jonsole/AmigaRGBtoHDMI/Amiga500CPLD/README.md

# Amiga 500 CPLD RGBtoHDMI

Amiga 500 CPLD RGBtoHDMI

This adaptor uses a CPLD to pass the RGB and sync signals from the Amiga 500 Denise socket to the Rasperry Pi Zero. It derives the pixel clock in a very different way to the c0pperdragon design and therefore does not require a jumper for Denise / Super Denise and has no "sparkling" pixel issues. It also has the advantage of being firmware upgradable if there are any issues found in the logic.

**ATTENTION PI Zero 2W users**: You can now use a Pi Zero 2W with the CPLD RGBtoHDMI using the December 24th 2021 release.

## BOM

| Symbol | Component |
| --- | --- |
| C1 - C3 | 0.1uF 0603 |
| J1 | 2x20pin 16.5mm tall socket 2.54mm |
| JP1 | 2pin right angle header 2.54mm |
| J2 | 1pin right angle header 2.54mm |
| R1 | 1K 0603 |
| R2 | 4.7K 0603 |
| U1 | 48pin DIP socket 2.54mm |
| U2 | 2x24pin SILs machined pins 2.54mm |
| U3 | XC9572XL 44pin QFP |

### Notes

- It is important that R1 is 1K due to the low value of the internal pull resistor in GPIO0 of the Pi, the other pull resistors are more flexible (R1 is optional as the Pi will pull this internally). If the value is too high then the software won't detect this is an Amiga board and won't show the correct firmware in the recovery menu.
- You'll need some kind of push button to connect to JP1
- J2 is optional, it is only needed for revision 3 motherboards to clip onto pin 9 of U41 on the Amiga (photo coming soon)
- The Pi mounting holes are M2.5, 11mm posts or 10mm with 1mm washers are recommended

## Pi Software Installation

The software on the Pi should be at least the latest 20210529 release from the [main tree](https://github.com/hoglet67/RGBtoHDMI/releases) or the latest [IanSB beta release](https://github.com/IanSB/RGBtoHDMI/releases) extracted onto a micro SD card in FAT32 format.

You need to copy some canned profile files into place for the board:

* `Amiga_CPLD_Readme/Amiga_CPLD_Setup/profile_6-12_BIT_RGB.txt` to the root of the SD card
* `Amiga_CPLD_Readme/Amiga_CPLD_Setup/Profiles/Default.txt` to the `Profiles` directory

This resolves some issues with mode switching, particularly on NTSC machines. The profile copied will automatically set `single_button_mode`.

## Flashing the CPLD

The CPLD will need flashing with the `6-12_BIT_RGB_CPLD` firmware. The other firmware options are not compatible with the profiles.

If you have followed the software steps above you will get a recovery menu, select `6-12_BIT_RGB_CPLD`, confirm and the Pi will flash the CPLD and reboot. You can then jump to the Initial Setup section below.

## Initial Setup

You may also a shimmer or wavy effect. This is because the phase is set incorrectly and needs calibration, this is a one-off easy thing to do. If you have a static image such as the Kickstart 1.3 boot screen or Workbench with no mouse movement you can use the "Auto Calibrate Video Settings" option (it will require you to select twice to activate). Alternatively you can go into the "Sampling" menu and change the "Sampling Phase" until the image looks correct. Typically 0, 3 or 5 will work fine, but it could be different in each machine.

Once calibrated choose "Save Configuration" and this will be remembered for subsequent boots.

## Buying PCBs

I've made the [PCBs available on PCBWay](https://www.pcbway.com/project/shareproject/Amiga_500_CPLD_RGBtoHDMI_v2_fb52eff9.html).

You can also purchase PCBs from me [via Tindie](https://www.tindie.com/products/linuxjedi/amiga-500-rgb-to-hdmi-pcb/).
