jonsole/AmigaRGBtoHDMI/Amiga500CPLD/A500.kicad_pcb

## KiCad design Amiga500CPLD/A500.kicad_pcb (2026-03-18)

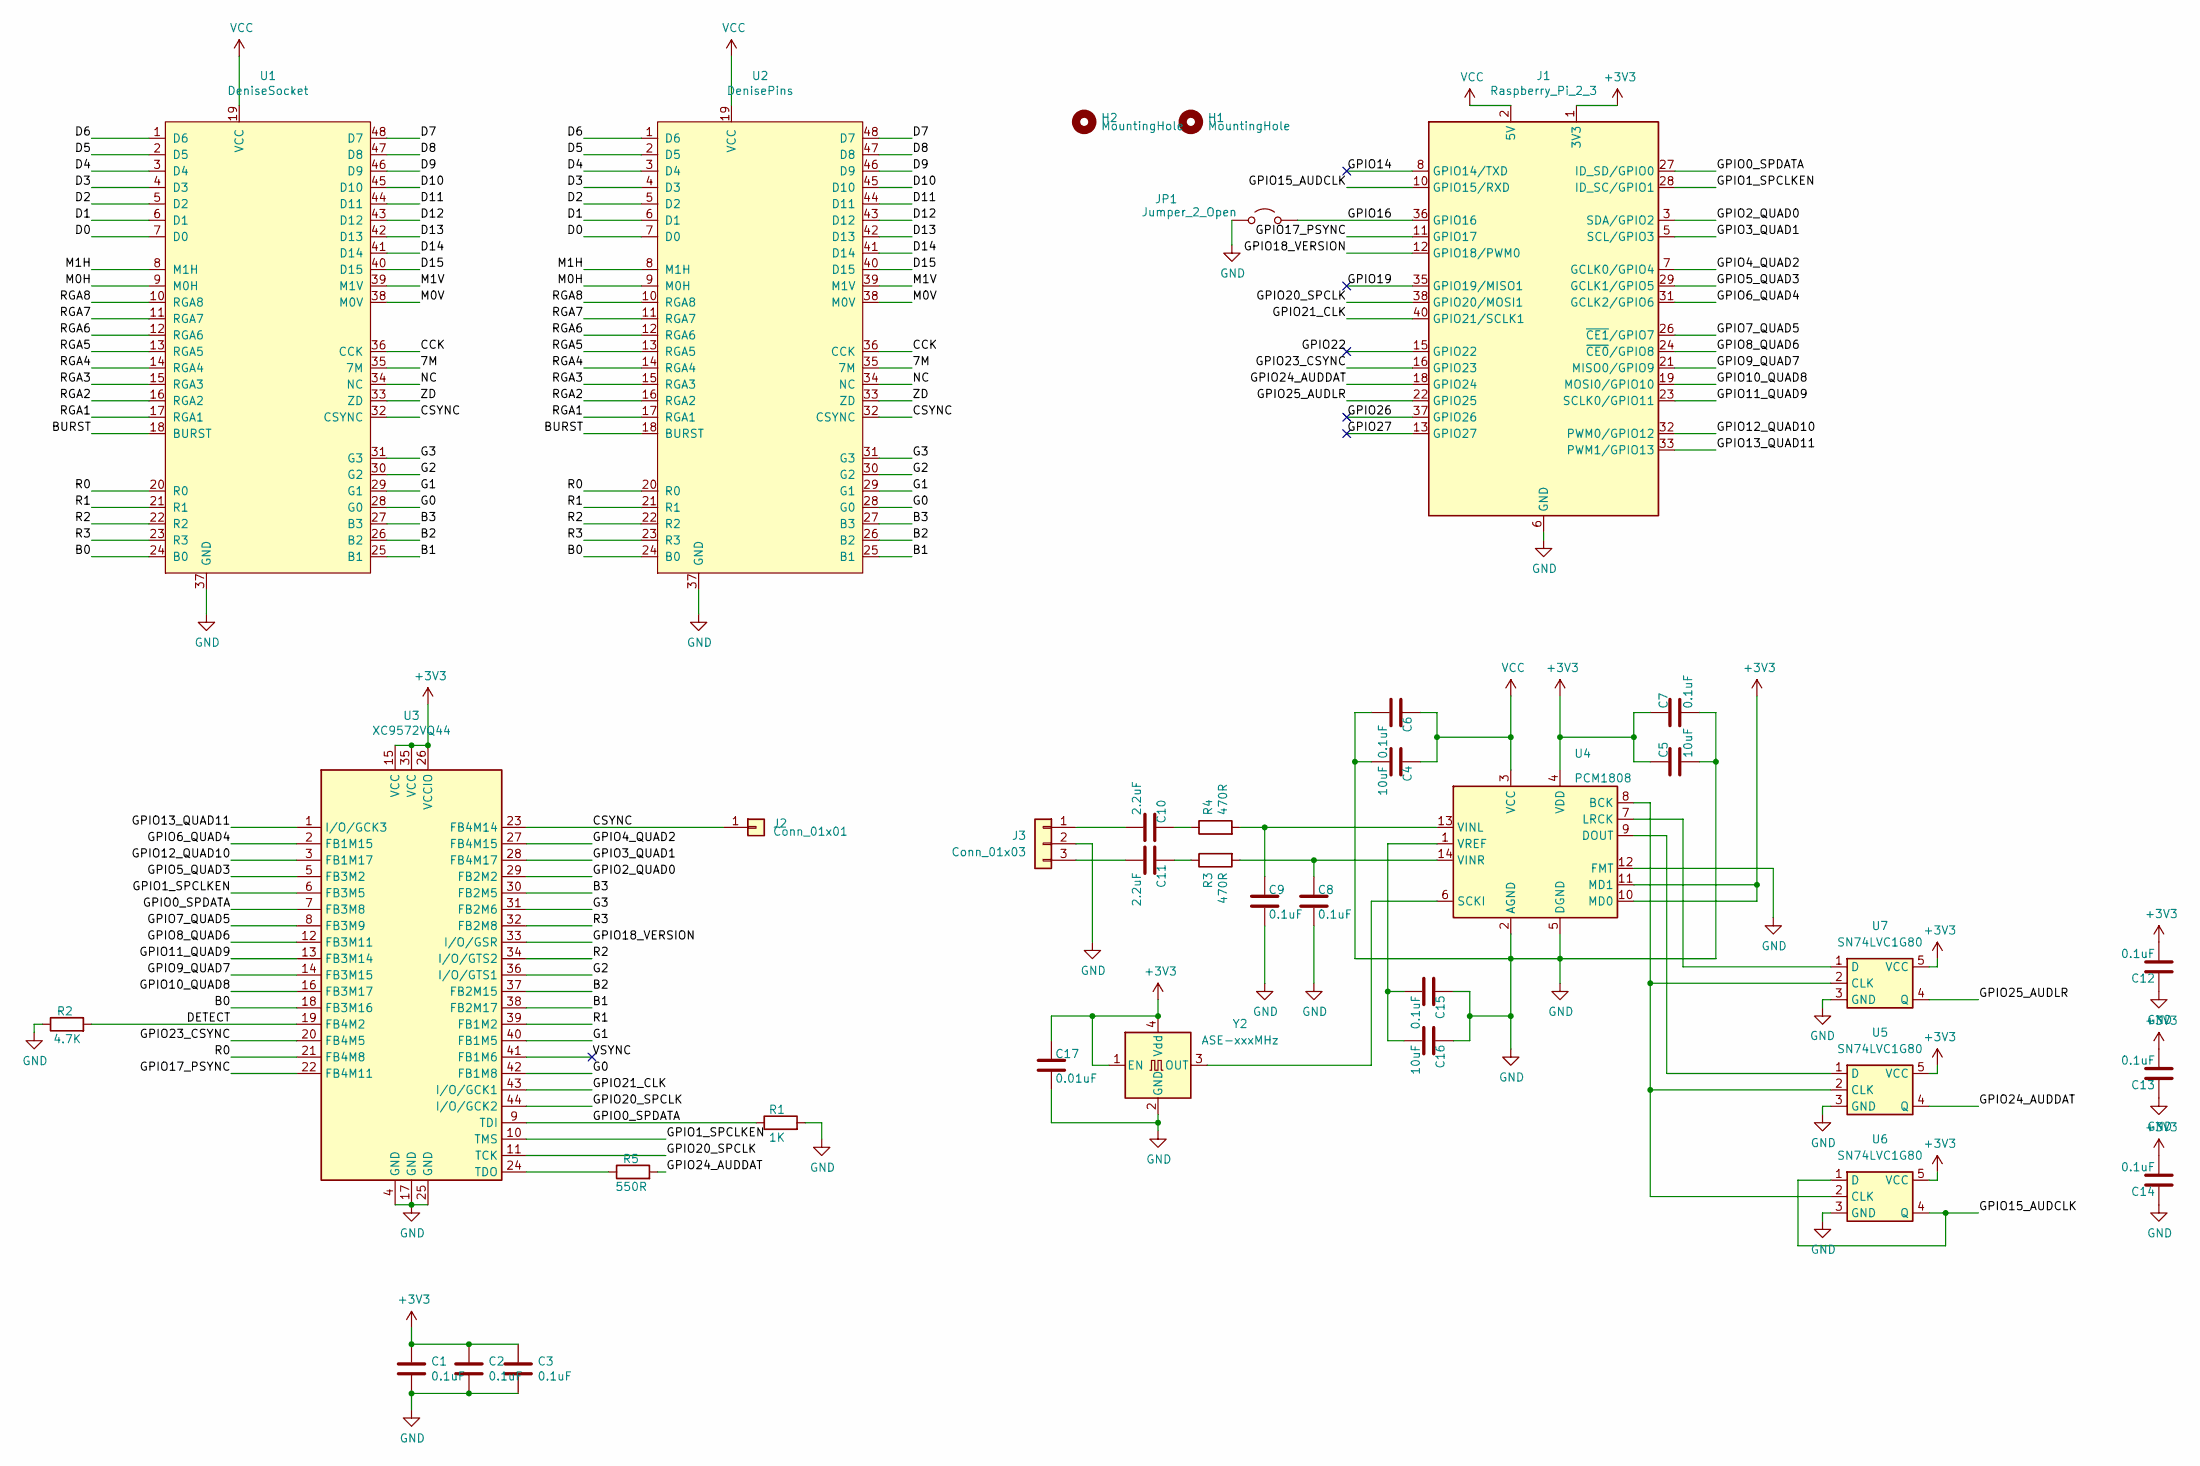
[picture p1: schematic A500.kicad_sch]

Parts:
C1, C2, C3, C6, C7, C8, C9, C12, C13, C14, C15: 0.1uF; C_0603_1608Metric_Pad1.08x0.95mm_HandSolder
C4, C5, C16: 10uF; C_0805_2012Metric_Pad1.18x1.45mm_HandSolder
C10, C11: 2.2uF; C_0805_2012Metric_Pad1.18x1.45mm_HandSolder
C17: 0.01uF; C_0603_1608Metric_Pad1.08x0.95mm_HandSolder
H1, H2: MountingHole; MountingHole_2.5mm_Pad
J1: Raspberry_Pi_2_3; Raspberry_Pi_Zero_Socketed_THT_FaceDown_MountingHoles
J2: Conn_01x01; PinHeader_1x01_P2.54mm_Horizontal
J3: Conn_01x03; PinHeader_1x03_P2.54mm_Horizontal
JP1: Jumper_2_Open; PinHeader_1x02_P2.54mm_Horizontal
R1: 1K; R_0603_1608Metric_Pad0.98x0.95mm_HandSolder
R2: 4.7K; R_0603_1608Metric_Pad0.98x0.95mm_HandSolder
R3, R4: 470R; R_0603_1608Metric_Pad0.98x0.95mm_HandSolder
R5: 550R; R_0603_1608Metric_Pad0.98x0.95mm_HandSolder
U1: DeniseSocket; DIP-48_W15.24mm_LongPads
U2: DenisePins; DIP-48_W15.24mm_LongPads
U3: XC9572VQ44; TQFP-44_10x10mm_P0.8mm
U4: PCM1808; TSSOP-14_4.4x5mm_P0.65mm
U5, U6, U7: SN74LVC1G80; Texas_R-PDSO-G5_DCK-5
Y2: ASE-xxxMHz; Oscillator_SMD_Abracon_ASE-4Pin_3.2x2.5mm

Connections:
+3V3: C1.1, C2.1, C3.1, C5.1, C7.1, C12.2, C13.2, C14.2, C17.1, J1.1 (3V3), J1.17 (3V3), U3.15 (VCC), U3.26 (VCCIO), U3.35 (VCC), U4.4 (VDD), U4.10 (MD0), U4.11 (MD1), U5.5 (VCC), U6.5 (VCC), U7.5 (VCC), Y2.1 (EN), Y2.4 (Vdd)
/7M: U1.35 (7M), U2.35 (7M)
/B0: U1.24 (B0), U2.24 (B0), U3.18 (FB3M16)
/B1: U1.25 (B1), U2.25 (B1), U3.38 (FB2M17)
/B2: U1.26 (B2), U2.26 (B2), U3.37 (FB2M15)
/B3: U1.27 (B3), U2.27 (B3), U3.30 (FB2M5)
/BURST: U1.18 (BURST), U2.18 (BURST)
/CCK: U1.36 (CCK), U2.36 (CCK)
/CSYNC: J2.1, U1.32 (CSYNC), U2.32 (CSYNC), U3.23 (FB4M14)
/D0: U1.7 (D0), U2.7 (D0)
/D1: U1.6 (D1), U2.6 (D1)
/D2: U1.5 (D2), U2.5 (D2)
/D3: U1.4 (D3), U2.4 (D3)
/D4: U1.3 (D4), U2.3 (D4)
/D5: U1.2 (D5), U2.2 (D5)
/D6: U1.1 (D6), U2.1 (D6)
/D7: U1.48 (D7), U2.48 (D7)
/D8: U1.47 (D8), U2.47 (D8)
/D9: U1.46 (D9), U2.46 (D9)
/D10: U1.45 (D10), U2.45 (D10)
/D11: U1.44 (D11), U2.44 (D11)
/D12: U1.43 (D12), U2.43 (D12)
/D13: U1.42 (D13), U2.42 (D13)
/D14: U1.41 (D14), U2.41 (D14)
/D15: U1.40 (D15), U2.40 (D15)
/DETECT: R2.2, U3.19 (FB4M2)
/G0: U1.28 (G0), U2.28 (G0), U3.42 (FB1M8)
/G1: U1.29 (G1), U2.29 (G1), U3.40 (FB1M5)
/G2: U1.30 (G2), U2.30 (G2), U3.36 (I/O/GTS1)
/G3: U1.31 (G3), U2.31 (G3), U3.31 (FB2M6)
/GPIO0_SPDATA: J1.27 (ID_SD/GPIO0), R1.1, U3.7 (FB3M8), U3.9 (TDI)
/GPIO1_SPCLKEN: J1.28 (ID_SC/GPIO1), U3.6 (FB3M5), U3.10 (TMS)
/GPIO2_QUAD0: J1.3 (SDA/GPIO2), U3.29 (FB2M2)
/GPIO3_QUAD1: J1.5 (SCL/GPIO3), U3.28 (FB4M17)
/GPIO4_QUAD2: J1.7 (GCLK0/GPIO4), U3.27 (FB4M15)
/GPIO5_QUAD3: J1.29 (GCLK1/GPIO5), U3.5 (FB3M2)
/GPIO6_QUAD4: J1.31 (GCLK2/GPIO6), U3.2 (FB1M15)
/GPIO7_QUAD5: J1.26 (~CE1/GPIO7), U3.8 (FB3M9)
/GPIO8_QUAD6: J1.24 (~CE0/GPIO8), U3.12 (FB3M11)
/GPIO9_QUAD7: J1.21 (MISO0/GPIO9), U3.14 (FB3M15)
/GPIO10_QUAD8: J1.19 (MOSI0/GPIO10), U3.16 (FB3M17)
/GPIO11_QUAD9: J1.23 (SCLK0/GPIO11), U3.13 (FB3M14)
/GPIO12_QUAD10: J1.32 (PWM0/GPIO12), U3.3 (FB1M17)
/GPIO13_QUAD11: J1.33 (PWM1/GPIO13), U3.1 (I/O/GCK3)
/GPIO14: J1.8 (GPIO14/TXD)
/GPIO15_AUDCLK: J1.10 (GPIO15/RXD), U6.1 (D), U6.4 (Q)
/GPIO16: J1.36 (GPIO16), JP1.2 (B)
/GPIO17_PSYNC: J1.11 (GPIO17), U3.22 (FB4M11)
/GPIO18_VERSION: J1.12 (GPIO18/PWM0), U3.33 (I/O/GSR)
/GPIO19: J1.35 (GPIO19/MISO1)
/GPIO20_SPCLK: J1.38 (GPIO20/MOSI1), U3.11 (TCK), U3.44 (I/O/GCK2)
/GPIO21_CLK: J1.40 (GPIO21/SCLK1), U3.43 (I/O/GCK1)
/GPIO22: J1.15 (GPIO22)
/GPIO23_CSYNC: J1.16 (GPIO23), U3.20 (FB4M5)
/GPIO24_AUDDAT: J1.18 (GPIO24), R5.2, U5.4 (Q)
/GPIO25_AUDLR: J1.22 (GPIO25), U7.4 (Q)
/GPIO26: J1.37 (GPIO26)
/GPIO27: J1.13 (GPIO27)
/M0H: U1.9 (M0H), U2.9 (M0H)
/M0V: U1.38 (M0V), U2.38 (M0V)
/M1H: U1.8 (M1H), U2.8 (M1H)
/M1V: U1.39 (M1V), U2.39 (M1V)
/NC: U1.34 (NC), U2.34 (NC)
/R0: U1.20 (R0), U2.20 (R0), U3.21 (FB4M8)
/R1: U1.21 (R1), U2.21 (R1), U3.39 (FB1M2)
/R2: U1.22 (R2), U2.22 (R2), U3.34 (I/O/GTS2)
/R3: U1.23 (R3), U2.23 (R3), U3.32 (FB2M8)
/RGA1: U1.17 (RGA1), U2.17 (RGA1)
/RGA2: U1.16 (RGA2), U2.16 (RGA2)
/RGA3: U1.15 (RGA3), U2.15 (RGA3)
/RGA4: U1.14 (RGA4), U2.14 (RGA4)
/RGA5: U1.13 (RGA5), U2.13 (RGA5)
/RGA6: U1.12 (RGA6), U2.12 (RGA6)
/RGA7: U1.11 (RGA7), U2.11 (RGA7)
/RGA8: U1.10 (RGA8), U2.10 (RGA8)
/VSYNC: U3.41 (FB1M6)
/ZD: U1.33 (ZD), U2.33 (ZD)
GND: C1.2, C2.2, C3.2, C4.2, C5.2, C6.2, C7.2, C8.2, C9.2, C12.1, C13.1, C14.1, C15.1, C16.1, C17.2, J1.6 (GND), J1.9 (GND), J1.14 (GND), J1.20 (GND), J1.25 (GND), J1.30 (GND), J1.34 (GND), J1.39 (GND), J3.2, JP1.1 (A), R1.2, R2.1, U1.37 (GND), U2.37 (GND), U3.4 (GND), U3.17 (GND), U3.25 (GND), U4.2 (AGND), U4.5 (DGND), U4.12 (FMT), U5.3 (GND), U6.3 (GND), U7.3 (GND), Y2.2 (GND)
unnamed: C10.1, R4.1
unnamed: C11.1, R3.1
unnamed: C10.2, J3.1
unnamed: C11.2, J3.3
unnamed: R5.1, U3.24 (TDO)
unnamed: U4.8 (BCK), U5.2 (CLK), U6.2 (CLK), U7.2 (CLK)
unnamed: U4.9 (DOUT), U5.1 (D)
unnamed: U4.7 (LRCK), U7.1 (D)
unnamed: U4.6 (SCKI), Y2.3 (OUT)
unnamed: C9.1, R4.2, U4.13 (VINL)
unnamed: C8.1, R3.2, U4.14 (VINR)
unnamed: C15.2, C16.2, U4.1 (VREF)
VCC: C4.1, C6.1, J1.2 (5V), J1.4 (5V), U1.19 (VCC), U2.19 (VCC), U4.3 (VCC)

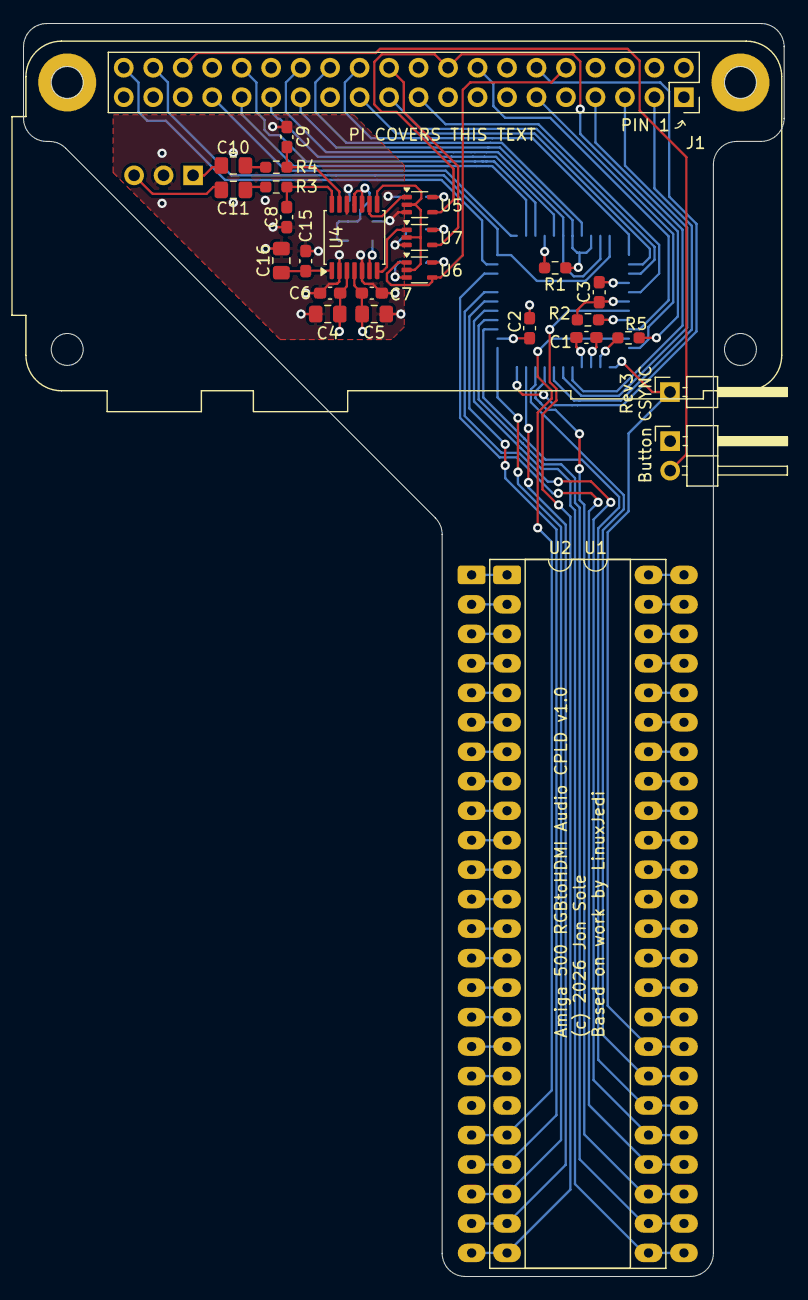
[picture p2: board A500.kicad_pcb from above]

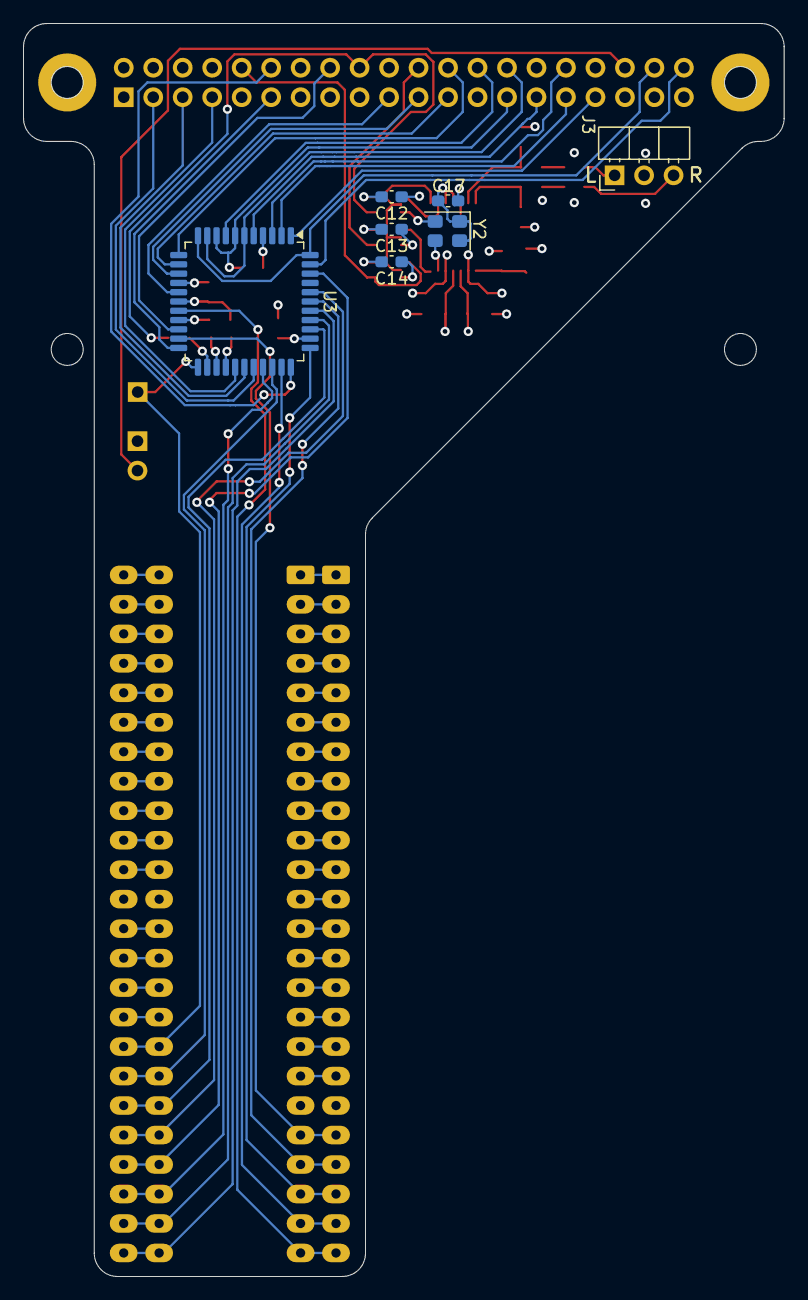
[picture p3: board A500.kicad_pcb from below]

Board: 4 copper layers, 65.5 x 108.0 mm, 36 parts (7 on the bottom side), 85 nets.
