jonsole/AmigaRGBtoHDMI/(commit log)

2026-03-18 Update design to include audio
    [A500.kicad_pcb, A500.kicad_sch]
2026-03-20 Remove old files
    [A500.kicad_sch, A500.sch]
