jonsole/AmigaRGBtoHDMI/(notices)

Notices in the files:
Amiga500CPLD/A500.kicad_pcb:
(c) 2026 Jon Sole
